karlduino/CO2monitor/docs/pics/README.md

## pics

- `shopping-cart.png` taken from <https://uxwing.com/shopping-cart-icon/>

- `s8_pin_assignment.jpg` taken from page 3 of the
  [specs](https://rmtplusstoragesenseair.blob.core.windows.net/docs/publicerat/PSP126.pdf)
  for the [SenseAir S8
  LP](https://senseair.com/products/size-counts/s8-lp/) sensor)
