karlduino/CO2monitor/docs/pics/01_with_template.jpg

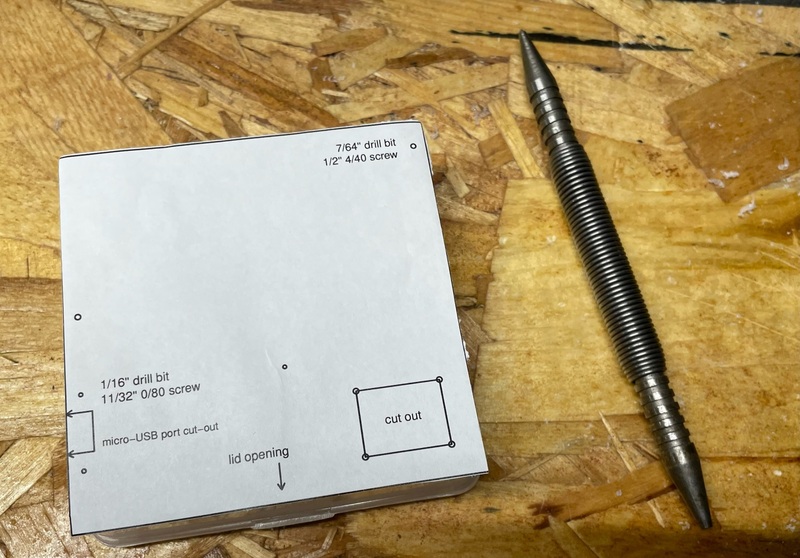
docs/pics/01_with_template.jpg
