karlduino/CO2monitor/docs/pics/02_with_marks.jpg

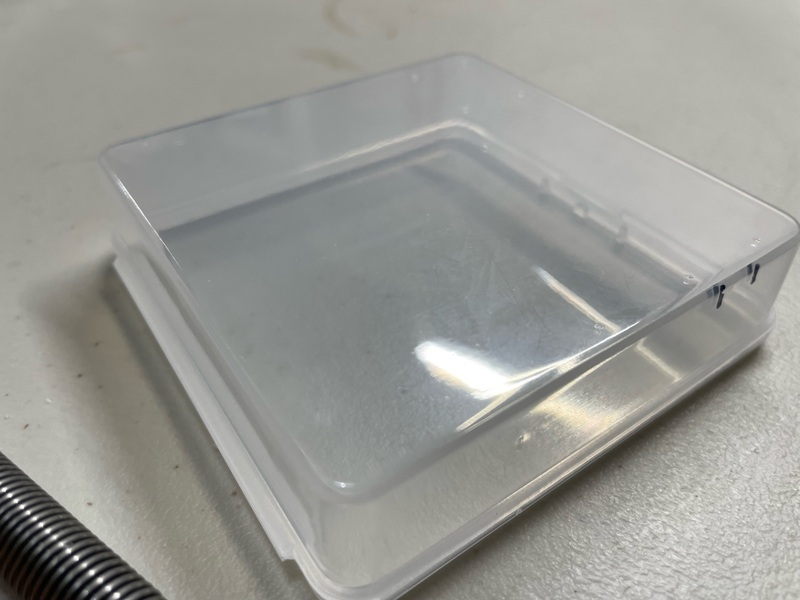
docs/pics/02_with_marks.jpg
