karlduino/CO2monitor/docs/pics/03_drilled.jpg

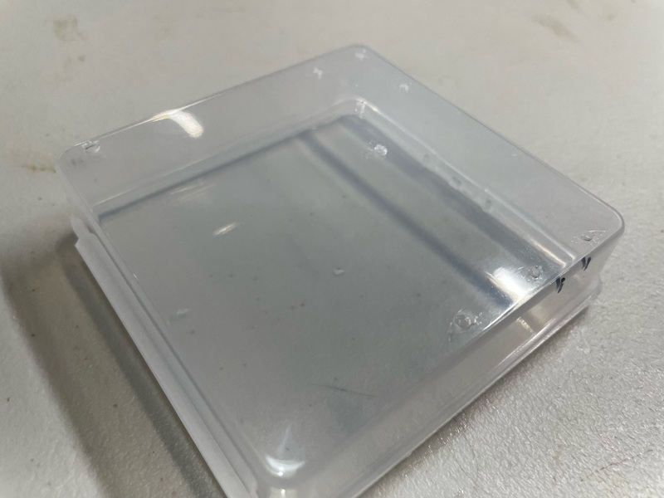
docs/pics/03_drilled.jpg
