karlduino/CO2monitor/docs/pics/04_holes_cut.jpg

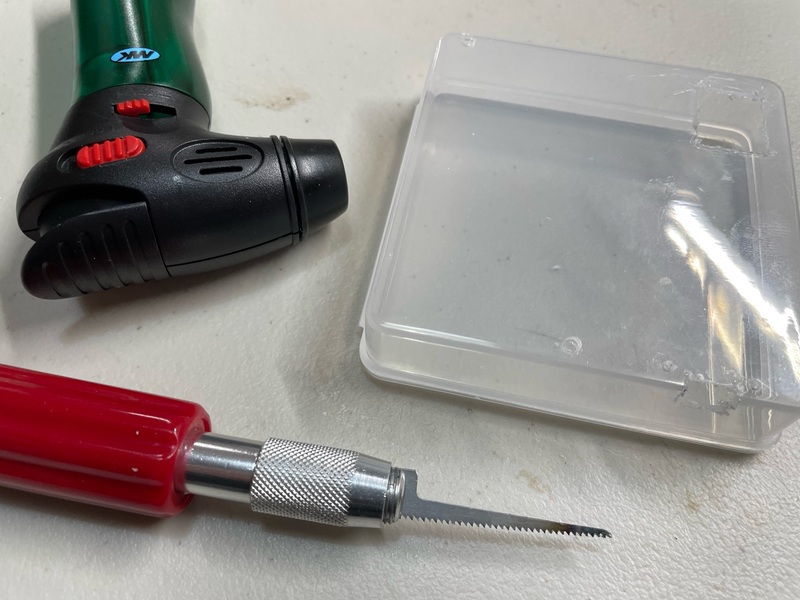
docs/pics/04_holes_cut.jpg
