karlduino/CO2monitor/docs/pics/06_blu_tack.jpg

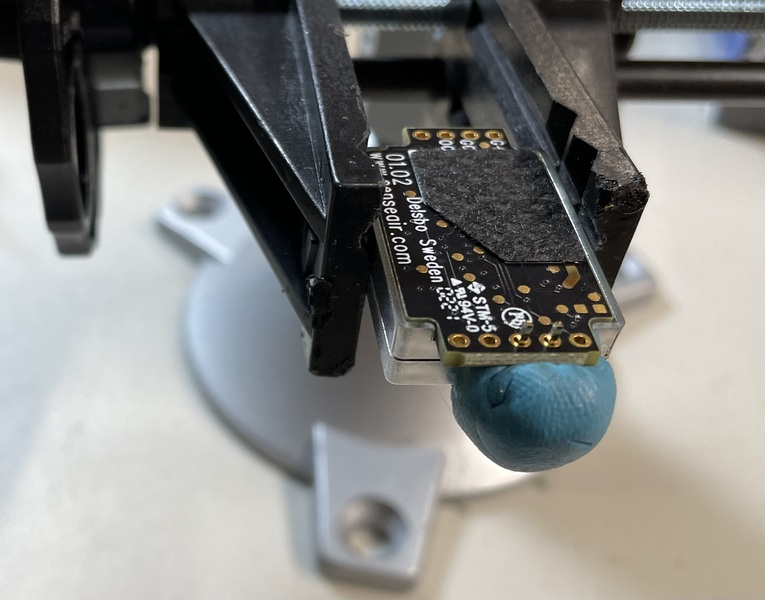
docs/pics/06_blu_tack.jpg
