karlduino/CO2monitor/docs/pics/08_arduino_on_breadboard.jpg

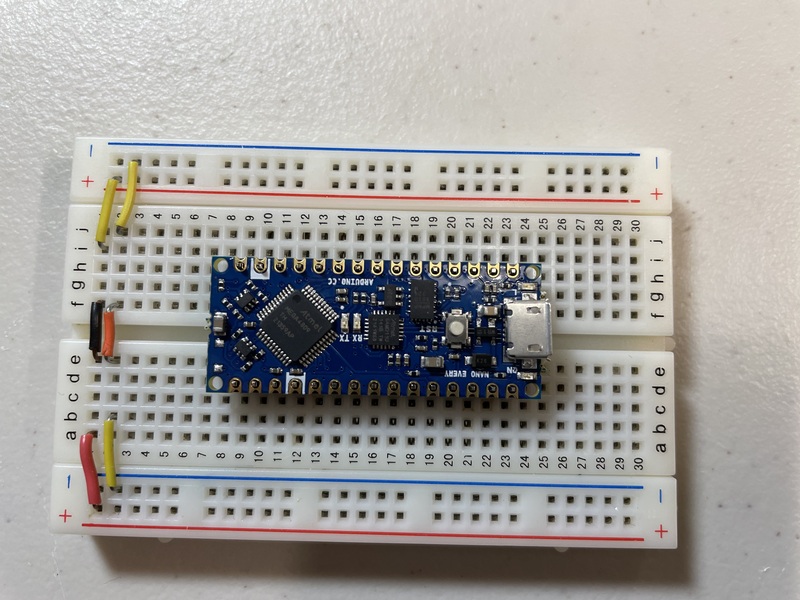
docs/pics/08_arduino_on_breadboard.jpg
