karlduino/CO2monitor/docs/pics/09_lcd_connections.jpg

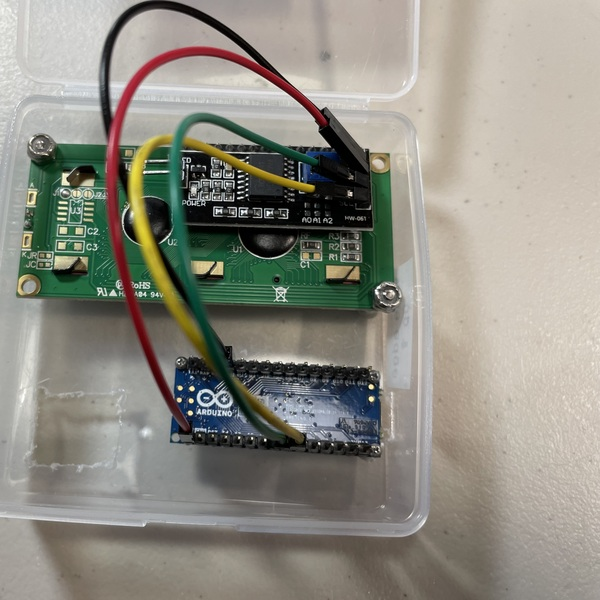
docs/pics/09_lcd_connections.jpg
