karlduino/CO2monitor/docs/pics/10_all_connections.jpg

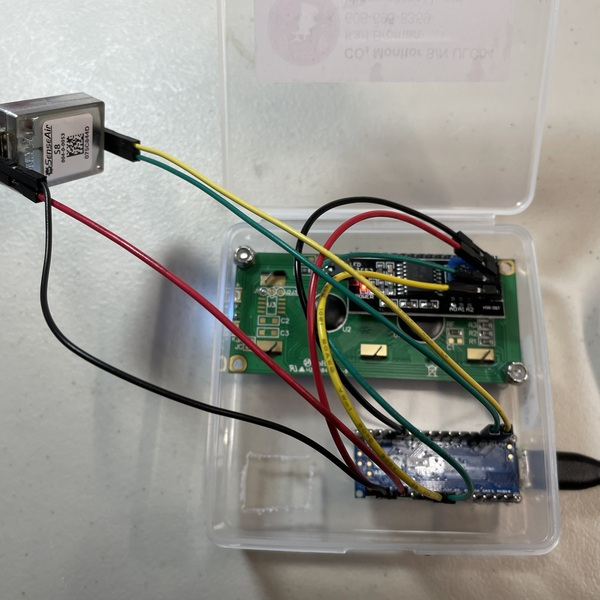
docs/pics/10_all_connections.jpg
