karlduino/CO2monitor/docs/pics/co2monitor.jpg

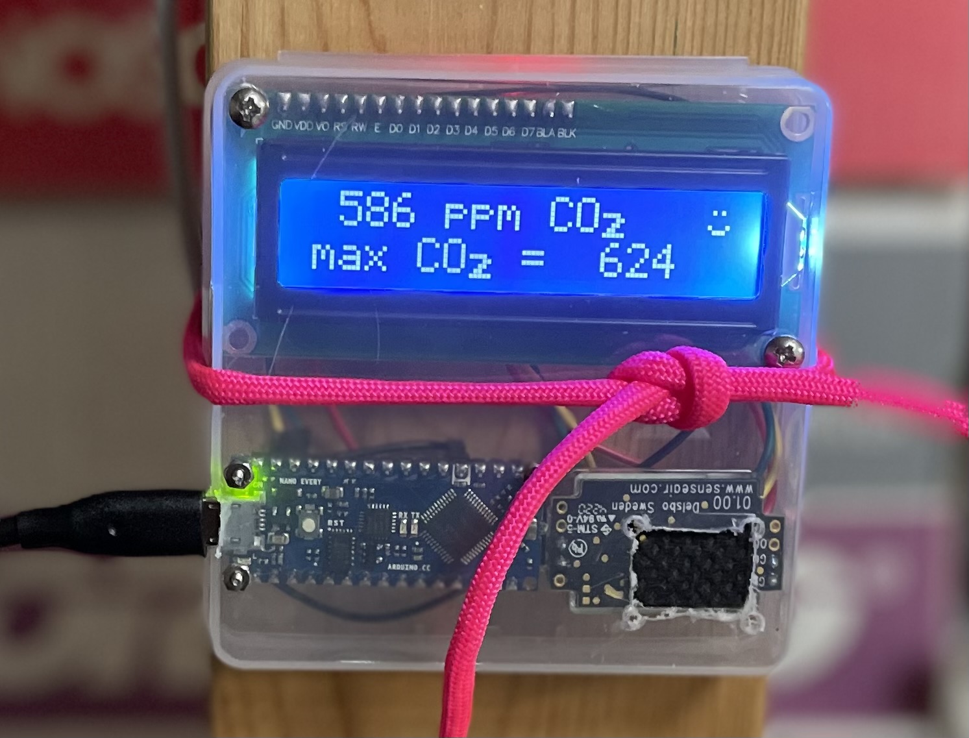
docs/pics/co2monitor.jpg
