karlduino/CO2monitor/docs/pics/s8_pin_assignment.jpg

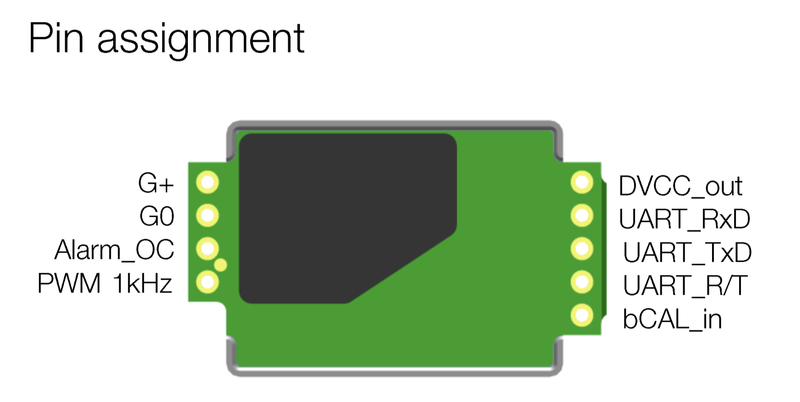
docs/pics/s8_pin_assignment.jpg
