karlduino/CO2monitor/docs/DrillTemplate/co2_monitor_drill_template.pdf

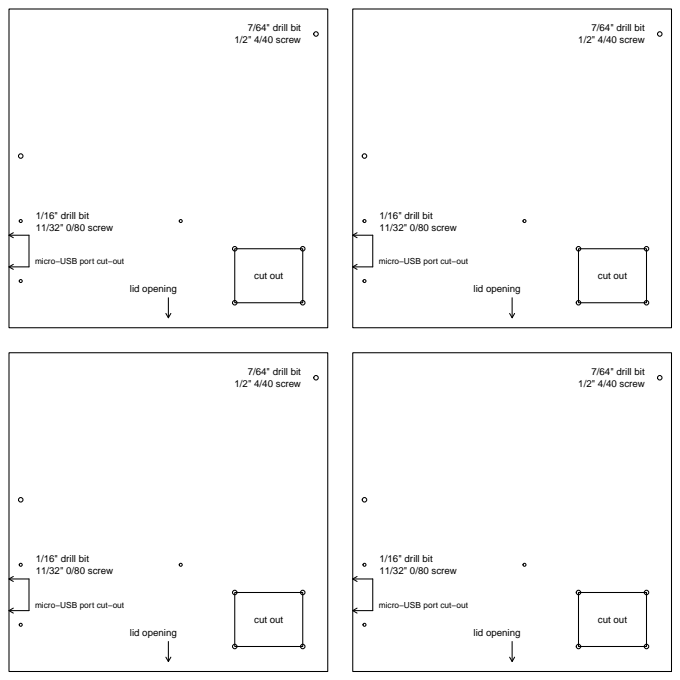
[picture p12: page 1]
7/64" drill bit 1/2" 4/40 screw; 1/16" drill bit 11/32" 0/80 screw; cut out; lid opening

micro−USB port cut−out
