karlduino/CO2monitor/docs/pics/05_sensor_before_soldering.jpg

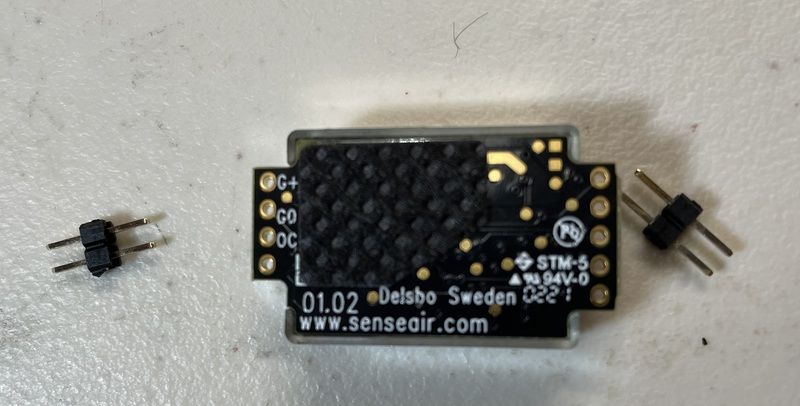
docs/pics/05_sensor_before_soldering.jpg
