karlduino/CO2monitor/docs/pics/07_sensor_after_soldering.jpg

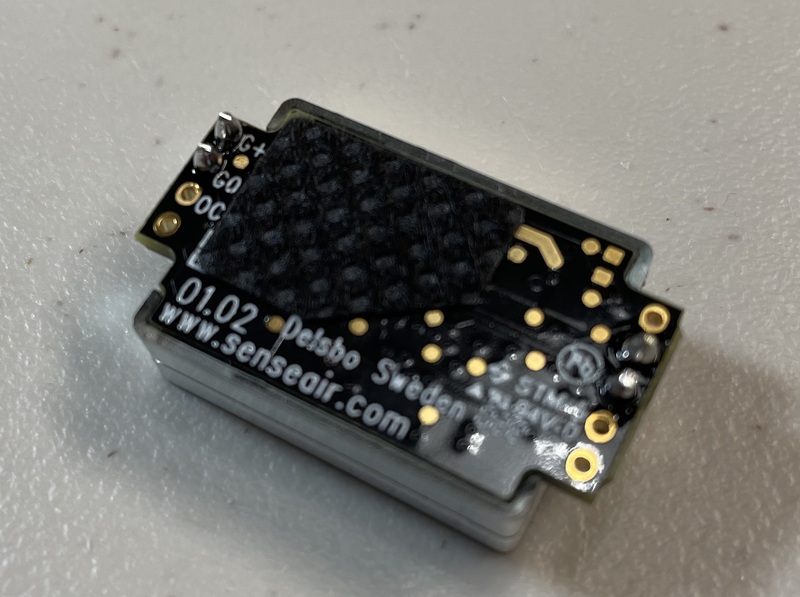
docs/pics/07_sensor_after_soldering.jpg
