karlduino/CO2monitor/docs/pics/11_wires_for_calibration.jpg

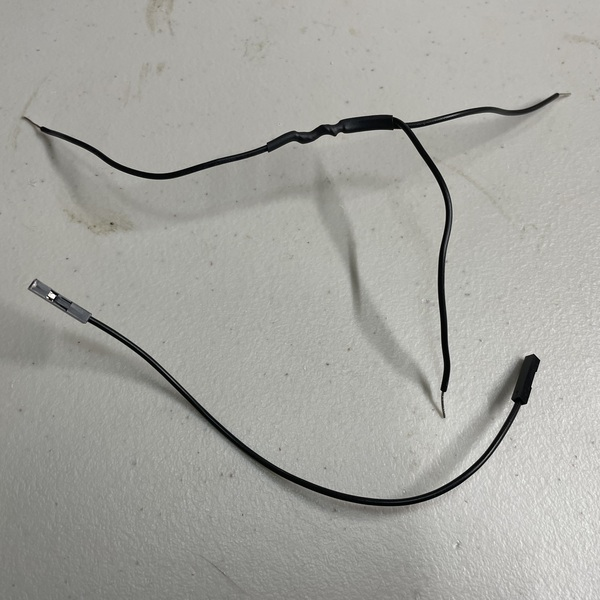
docs/pics/11_wires_for_calibration.jpg
