karlduino/CO2monitor/docs/pics/comparison_experiment.jpg

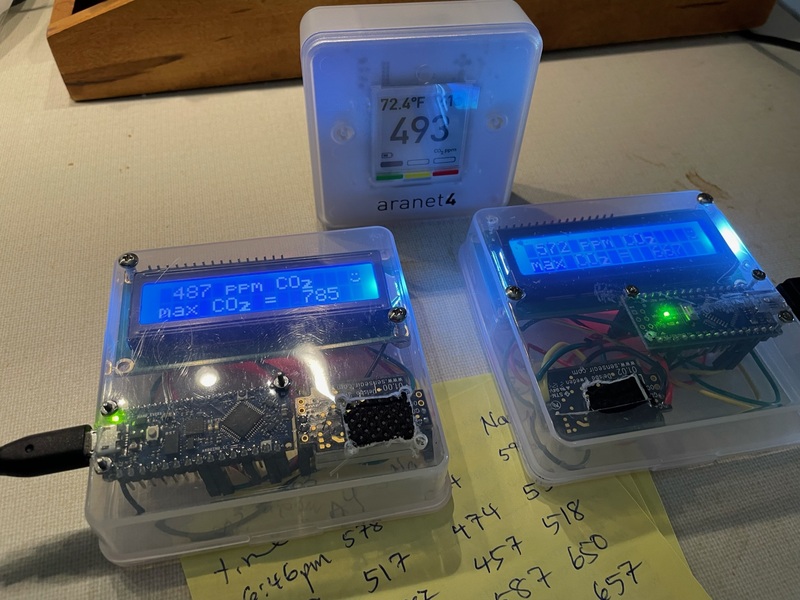
docs/pics/comparison_experiment.jpg
