karlduino/CO2monitor/docs/pics/needs_calibration.jpg

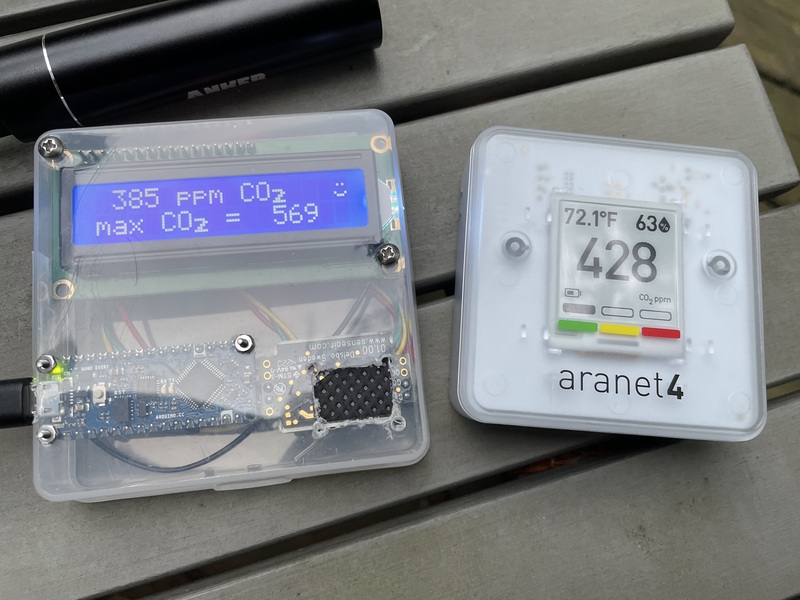
docs/pics/needs_calibration.jpg
