karlduino/CO2monitor/(commit log)

2022-08-30 Add subscript 2 plus a couple of delays
2022-09-01 Add R code + pdf with layout for drilling holes
2022-09-02 Layout: Need to swap placement of two screws
2022-09-02 Need to switch LCD libraries for the arduino nano every
2022-09-03 Clean up, but leaving some debug code; still not working for nano every
    [CO2monitor.ino]
2022-09-03 Fix a couple of problems in the README
2022-09-03 Add some debug code; switch RX/TX pins
2022-09-03 Ooo got it working on the arduino every
    - just needed to be more lenient in reading the firmware
    from the sensor.
2022-09-03 Layout -> DrillTemplate
2022-09-03 DrillTemplate/README: link to pdf of template
2022-09-03 README: link to arduino libraries' github repos
2022-09-03 README: Fix pin connection info
2022-09-03 Move DrillTemplate/ into docs/
2022-09-03 Remove ../ from ../DrillTemplate/....
2022-09-04 instructions: fix error re screw length; change order of "tape box shut" and "load software"
2022-09-04 Add some comparitive data
    [data.csv]
2022-09-04 Fix typo in the data
    [data.csv]
2022-09-04 README: emphasize that most of the cost is the sensor
2022-09-04 Update pic of sensor to show the smiley
2022-09-04 Add photo of sensor needing calibration
2022-09-05 Point to Mariete blog + cheaper source for the sensor
2022-09-05 docs/Comparison: add pic of S8 sensor needing calibration, plus discussion
2022-09-05 Photos of soldering the S8
2022-09-05 instructions.md: add more soldering details, including pics
2022-09-05 instructions.md: powering -> power
2022-09-06 Revise the instructions: skip the punch tool and just use the 1/16" drill bit
2022-09-07 Mention McMaster-Carr as source for screws
2022-09-10 instructions.md: revise discussion of soldering the Arduino
2022-09-10 instructions.md: fix typo; mention shorts between screws and USB
2022-09-10 Add pictures of arduino on breadboard + connections
2022-09-10 Add calibration info to instructions
2022-09-10 Add a picture of the wires used for calibration
2022-09-10 instructions.md: a bit more about calibration
2022-09-14 Creating an alternate arduino sketch
    - got a different LCD display with I2C integrated, but using a
    different controller and so needing a different library
    plus different wiring
2022-09-14 Revise arduino sketch for alternate LCD display
    - uses RW1063 controller, which is the same as HD44780
    - need to use LiquidCrystalWired library
    - address is 0x3C
2022-09-24 Change alt text for a pic in the assembly instructions
